ling99LL/ag32-logic-analyzer/docs/README.md

# 文档索引

| 路径 | 内容 |
|---|---|
| `docs/HANDOVER.md` | 环境、烧录流程、CPLD 三段式编译和排障 |
| `docs/reports/PERFORMANCE_REPORT.md` | 采样、触发、USB 吞吐和连续压测 |
| `docs/reports/TEST_REPORT_2026-10-21_PIN5_CH1.md` | PIN_5 到 CH1 的最近一次板级回环报告 |
| `docs/images/plan_b_live_waveform.svg` | 方案 B 实时波形示意 |

新增长期维护的分析和测试结论放 `reports/`；照片与截图优先放对应工程目录，跨工程示意图才放 `images/`。
