ling99LL/ag32-logic-analyzer/mcp/docs/images/ag32-logic-studio-mobile.png

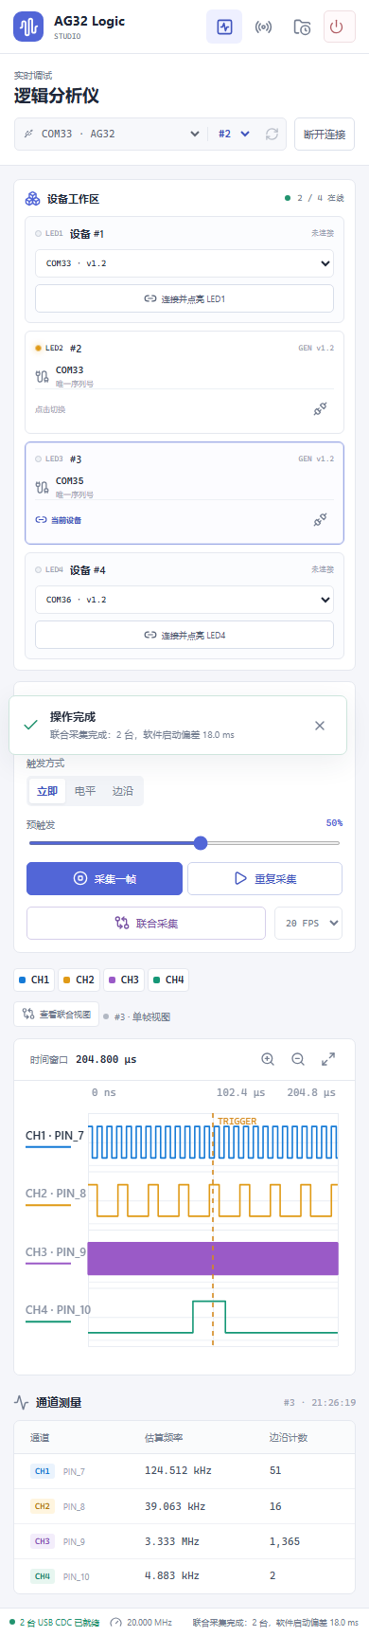
mcp/docs/images/ag32-logic-studio-mobile.png
