ling99LL/ag32-logic-analyzer/hardware/enclosure/top-case.step

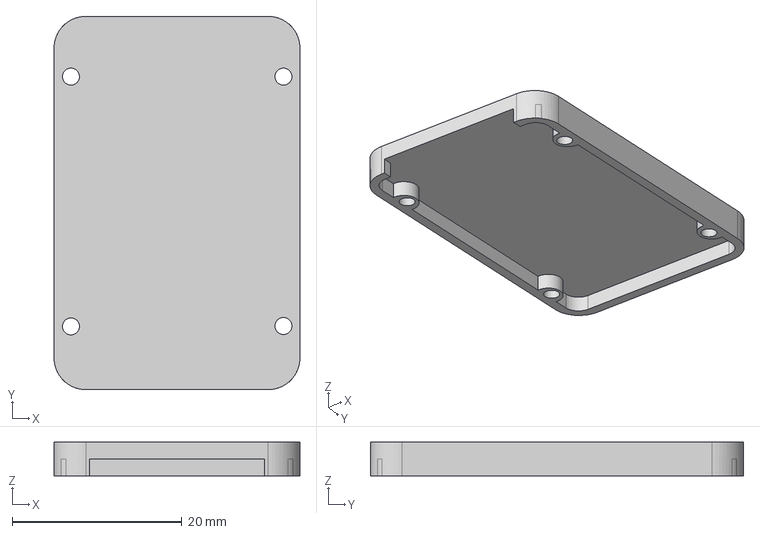
[picture p14: CAD file, 2026-10-21]
hardware/enclosure/top-case.step
29.0 x 44.0 x 4.00 mm
