ling99LL/ag32-logic-analyzer/hardware/enclosure/bottom-case.step

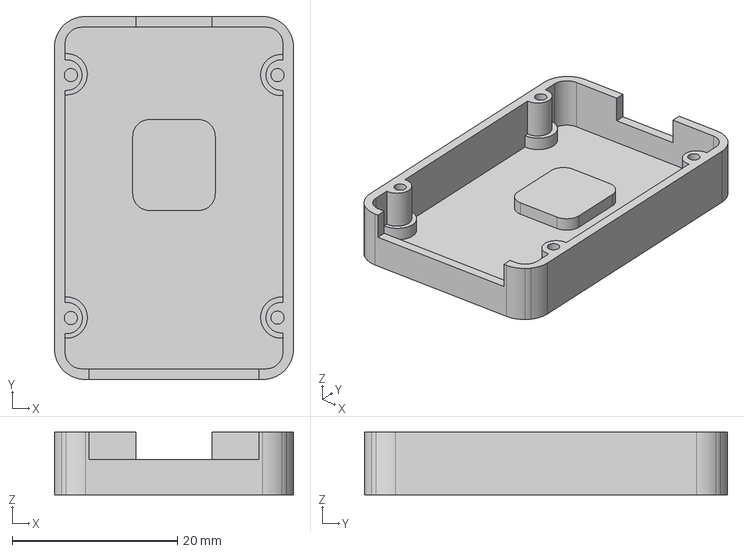
[picture p15: CAD file, 2026-10-21]
hardware/enclosure/bottom-case.step
29.0 x 44.0 x 7.60 mm
