ling99LL/ag32-logic-analyzer/hardware/images/assembled-board-hero.jpg

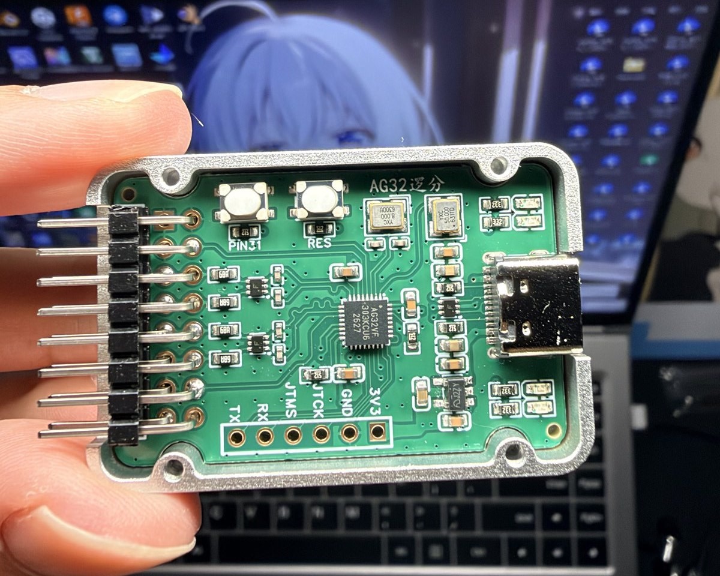
hardware/images/assembled-board-hero.jpg
