ling99LL/ag32-logic-analyzer/hardware/images/assembled-board-portrait.jpg

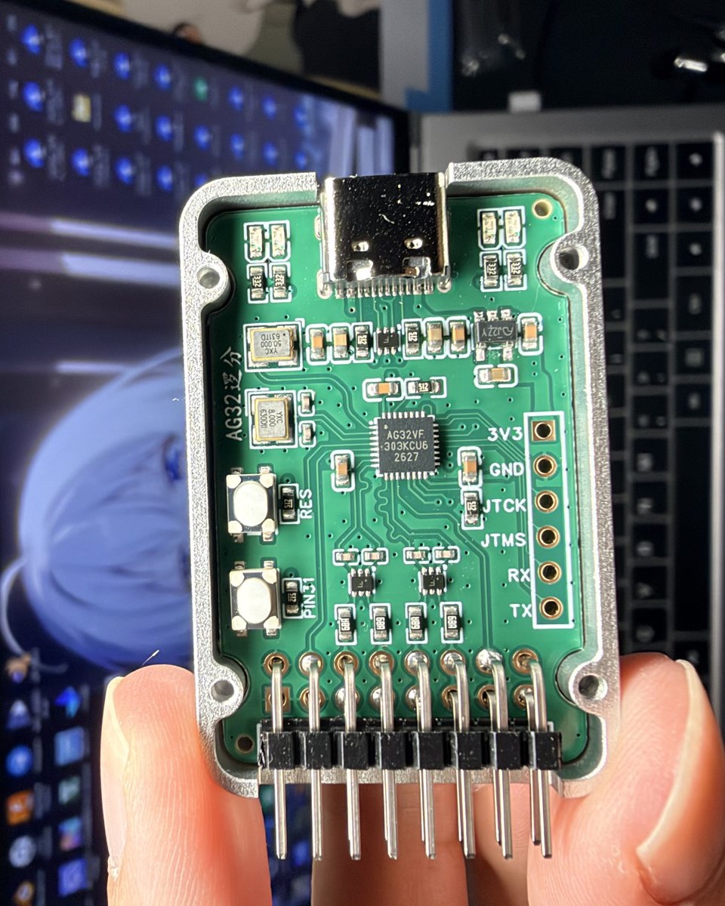
hardware/images/assembled-board-portrait.jpg
