ling99LL/ag32-logic-analyzer/hardware/images/assembled-board.jpg

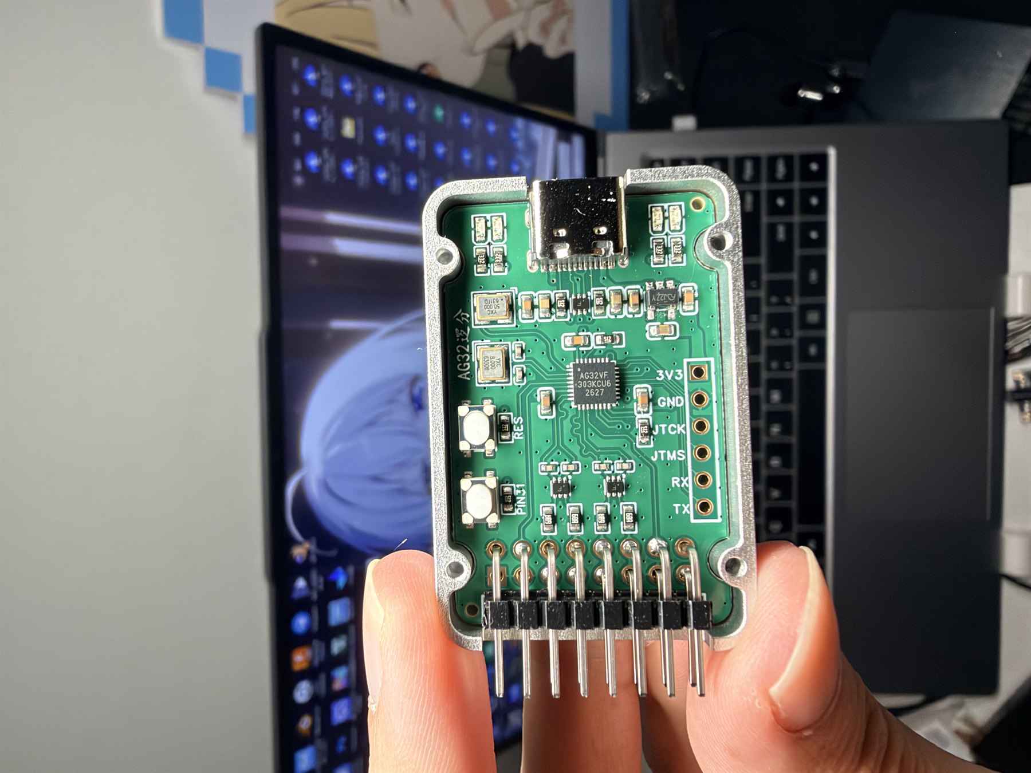
hardware/images/assembled-board.jpg
