ling99LL/ag32-logic-analyzer/TEST_REPORT_2026-10-21_PIN5_CH1.md

# Logic PIN_5 -> CH1 回环与性能测试报告

- 测试日期：2026-10-21
- 测试对象：AG32VF303 QFN32 逻辑分析仪
- 固件版本：`v1.1`
- 设备接口：`COM33`，SUMP ID `1ALS`
- 当前接线：`PIN_5` 数字输出 -> `CH1/PIN_7`
- 芯片采样基准：`100 MHz/(div+1)`，最高 `100 MSa/s`
- DAC 输出速率上限：`5 MSa/s`

## 1. 接线确认

本轮只连接了 `PIN_5 -> CH1/PIN_7`。

| 时间点 | CH1/PIN_7 | CH2/PIN_8 | CH3/PIN_9 | CH4/PIN_10 |
|---|---:|---:|---:|---:|
| PIN_5 关闭 | 0 边沿 | 0 边沿 | 0 边沿 | 0 边沿 |
| PIN_5 输出 100 kHz | 16 边沿 | 0 边沿 | 0 边沿 | 0 边沿 |
| DAC 使能但未接输入 | 仍为 PIN_5 信号 | 0 边沿 | 0 边沿 | 0 边沿 |

结论：

- `PIN_5` 确实只回读到 `CH1/PIN_7`。
- `CH2~CH4` 均保持静态，未观察到他路信号或浮空串扰。
- `PIN_11` 本轮未接任何输入，DAC 只能完成协议级测试，不能做物理波形捕获。

## 2. 冒烟测试

运行命令：

```powershell
cd <repository>
python .\tools\smoke_test.py COM33
```

结果：`23 PASS / 1 FAIL / 24 total`

通过项包括：

- SUMP/OLS 握手：`1ALS`
- GEN `v1.1`、DAC 关闭、PIN_5 方波源启动状态
- CPLD 8192 点满深捕获
- PIN_5 100 kHz、1 MHz、10 MHz 方波回环
- 触发/脉冲引擎寄存器级时序
- DAC 四波形协议与关闭状态
- 默认状态恢复

唯一失败项：

```text
脉冲波形: 延时~0.2s 上升 + 0.3s 高电平
上升沿@320ms，高电平宽=300ms
```

该失败不是脉冲宽度错误。旧脚本先发送 `fire`，再逐条配置采样参数，因此把主机配置耗时算进了期望的 200 ms 延时。实际高电平宽度为准确的 300 ms。

改用硬件上升沿触发复核后：

```text
bytes: 8192
high: 3000
low: 5192
edges: [5186, 8186]
pulse_width_ms: [300.0]
CH2/CH3/CH4 edges: [0, 0, 0]
```

结论：脉冲引擎和采样通道工作正常，冒烟脚本的波形起点判断需要后续修正。

## 3. 高频回环

### 3.1 标准回归

运行命令：

```powershell
python .\live_hardware_test.py
```

8 档时基全部通过，但脚本内置的高频子测试只在切换 `TEST_DIV` 后等待 10 ms。该等待时间不足以让 50 MHz 方波稳定进入当前采样相位，因此出现过一次：

```text
50 MHz @ 100 MSa/s: edges=0, expected=1024, FAIL
```

25 MHz、10 MHz 及更低频点均通过。

### 3.2 增加稳定时间后的复测

将 `PIN_5` 频率切换后等待 50 ms，再启动 100 MSa/s、8192 点捕获：

| PIN_5 频率 | 采样点/周期 | 捕获次数 | 边沿范围 | 占空比 | 结果 |
|---:|---:|---:|---:|---:|---|
| 50 MHz | 2 | 100 | 8191/8191 | 50.0% | 100/100 PASS |
| 33.333 MHz | 3 | 20 | 5460~5461 | 66.7% | 20/20 PASS |
| 25 MHz | 4 | 20 | 4095~4096 | 50.0% | 20/20 PASS |

结论：

- 等待 10 ms 时，50 MHz 存在偶发相位锁定失败。
- 等待 50 ms 后，50 MHz 连续 100 帧均为严格 `1010...` 交替模式，可稳定回环。
- `50 MHz` 是 `100 MSa/s` 下的奈奎斯特极限，只有 2 点/周期。
- `PIN_5` 虽然可配置到 100 MHz，但 100 MHz 在 100 MSa/s 下只有 1 点/周期，无法可靠恢复波形。
- 协议解码建议信号不超过 25 MHz，以保证每 bit 至少 4 个采样点。

## 4. 采样时基

`live_hardware_test.py` 的 8 档绝对时基检查全部通过：

| 采样率 | 分频 | 测试源频率 | 捕获结果 |
|---:|---:|---:|---|
| 100 MSa/s | 0 | 50 MHz | 512 High / 512 Low，1023 边沿 |
| 50 MSa/s | 1 | 25 MHz | 512 High / 512 Low，1023 边沿 |
| 20 MSa/s | 4 | 10 MHz | 512 High / 512 Low，1023 边沿 |
| 10 MSa/s | 9 | 20 kHz | 500 High / 524 Low，4 边沿 |
| 5 MSa/s | 19 | 20 kHz | 518 High / 506 Low，9 边沿 |
| 2 MSa/s | 49 | 20 kHz | 508 High / 516 Low，21 边沿 |
| 1 MSa/s | 99 | 20 kHz | 514 High / 510 Low，41 边沿 |
| 100 kSa/s | 999 | 20 kHz | 614 High / 410 Low，410 边沿 |

关键指标：

- 最高采样率：`100 MSa/s`
- 时间分辨率：`10 ns`
- BRAM 满深：`8192` 点
- 100 MSa/s 满深时间窗口：`81.92 us`

## 5. USB 与连续性能

### 5.1 纯 USB CDC 连续吞吐

运行命令：

```powershell
python .\benchmark_usb_suite.py
```

| 负载 | 接收字节 | 耗时 | 有效吞吐 | 线速率 |
|---:|---:|---:|---:|---:|
| 16 KB | 16384 | 15.57 ms | 1027.49 KB/s | 8.42 Mbps |
| 32 KB | 32768 | 30.32 ms | 1055.33 KB/s | 8.65 Mbps |
| 64 KB | 65536 | 60.46 ms | 1058.53 KB/s | 8.67 Mbps |
| 128 KB | 131072 | 121.75 ms | 1051.33 KB/s | 8.61 Mbps |
| 256 KB 首轮 | 262144 | 325.47 ms | 786.55 KB/s | 6.44 Mbps |

256 KB 首轮出现了 Windows CDC 调度抖动。连续复测 3 次：

```text
1011.75 KB/s
1012.08 KB/s
1002.70 KB/s
```

因此 256 KB 连续流稳定值约为 `1.00~1.01 MB/s`，单次 786 KB/s 不是持续吞吐上限。

### 5.2 满深捕获上传

`live_hardware_test.py` 的 8192 点上传：

```text
Upload Length: 8192 / 8192 bytes
Effective Net USB: 1003.6 KB/s
Pure upload time: 7.97 ms
```

### 5.3 满深连续压测

测试配置：100 MSa/s、8192 点、连续 200 帧。

结果：

- 完整帧：`200/200`
- 丢帧：`0`
- 端到端帧率：`21.92 FPS`
- 平均单帧：`45.58 ms`
- 最短单帧：`42.82 ms`
- 最长单帧：`123.54 ms`
- 端到端有效吞吐：`175.4 KB/s`

当前固件每次上传后固定保留 35 ms LED 展宽，因此连续满深帧率主要受该延时限制，而不是 USB 或 CPLD 采样限制。

## 6. 最终结论

1. `PIN_5 -> CH1/PIN_7` 单线回环工作正常，其他通道无串扰。
2. 逻辑分析仪最高采样率为 `100 MSa/s`，对应 `10 ns` 分辨率。
3. 当前已验证的最高数字回环频率为 `50 MHz`，但必须满足 2 点/周期的奈奎斯特条件。
4. 50 MHz 测试必须在修改 `TEST_DIV` 后等待约 50 ms；现有脚本的 10 ms 等待会产生偶发假失败。
5. 25 MHz 及以下具有至少 4 点/周期，可靠性更高，适合协议解码。
6. 纯 USB CDC 峰值实测 `1058.53 KB/s`，256 KB 连续流稳定约 `1.00~1.01 MB/s`。
7. 满深连续捕获 `200/200` 帧通过，端到端约 `21.92 FPS`。

测试结束后设备恢复为：

- 固件 `v1.1`
- `FLAGS=0x02`
- DAC 关闭
- `PIN_5` 方波源，100 kHz
- SUMP ID `1ALS`
