ling99LL/ag32-logic-analyzer/(commit log)

2026-10-08 feat(logic): 新增 AG32VF303 4通道逻辑分析仪工程 (QFN-32版，支持SUMP与PulseView原生对接)
    - 硬件平台：AG32VF303 (AGRV2KQ32) QFN-32 封装适配
    - 采样通道：PIN_7~10 (CH0~CH3) + PIN_11 (TEST_OUT 自检方波输出)
    - 状态指示：PIN_12/13/14/18 (4颗LED) 支持上电自检、待机跑马灯与状态指示
    - 协议引擎：兼容 SUMP/OLS 标准协议，原生支持 PulseView / Sigrok
    - 性能实测：64KB 单次采集深度，USB CDC 传输带宽约 827 KB/s
    - 包含工程源码、VE约束、测试脚本及完整技术说明文档
2026-10-08 feat(logic): upgrade to Plan B CPLD hardware sampler (100MSa/s, BRAM buffer, HW trigger)
2026-10-08 feat(logic): support extended multi-stage SUMP trigger stages (0xC0..0xCF)
2026-10-08 feat(cpld): implement true hardware edge-trigger engine and wire to SUMP protocol
2026-10-08 feat(logic): add multi-sample-rate signal verification script
2026-10-08 feat(logic): support SUMP pre-trigger sample delay parsing
2026-10-08 feat(logic): adaptively scale CPLD test wave frequency to sample timebase
2026-10-08 feat(comm): non-blocking dual-port dispatch preventing UART from throttling USB CDC
2026-10-08 fix(logic): wire CPLD hardware edge trigger bit and align SUMP trigger mask/val parsing
2026-10-08 feat(cpld): add 2-stage input synchronizer pipeline for instant edge triggering and update 800fps bench
2026-10-08 feat(led): enhance LED visual feedback with extended stretch and rotating heartbeat
2026-10-10 fix(logic): hardware-verified SUMP sampler corrections
    - timebase: sample rate = 100MHz/(div+1) on a real 100MHz bus domain (VE adds BUSCLK 100); 16-bit divider fixes truncation above divider 255 (100kSa/s was really 431kSa/s)
    - implement true circular pre-trigger buffer in CPLD (pre-fill + trig_pos latch + post_cnt) and read the window around REG_TRIG_POS in firmware
    - latch trigger every bus cycle (trig_pending) so edge trigger works on phase-locked signals (self-test wave never triggered before, only force-timeout)
    - fix REG_CTRL readback layout (was 33-bit concat shifted one bit); verified via OpenOCD mem2array
    - fix run_la.py swapped SUMP 0xC0(mask)/0xC1(value); fix all scripts to s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
2026-10-10 feat(logic): raise self-test square wave to 10/25/50 MHz + on-board loopback verification
2026-10-12 fix(logic): resurrect DAC hard macro + calibrate DMA pacing; add board test tools
    - analog_ip.v: keep-guard (preserve register) on the dangling dac_dout - Quartus
    had deleted the whole alta_dac macro as dead logic, which silently killed the
    PIN_11 analog output and the Supra FIXED_COORD {22 11} binding
    - run_quartus_steps.bat: new [1/7] af_ip.tcl step generating the alta_auto macro
    partitions, plus two hard guards (missing partition in qsf / missing alta_dac
    in the netlist abort the build) so this regression cannot ship again
    - main.c: repeat the wave table across the whole DMA buffer and set the LLI
    transferSize to the full buffer (reloads every few samples stole DMA request
    s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
2026-10-12 docs(logic): record DAC macro fix, pacing calibration and loopback 18/18 in handover/README/AGENTS
    - HANDOVER: new "当前版本" (62f7375, board now matches the repo), loopback 18/18
    results, smoke 19/19 final, the alta_dac keep-guard / partition-guard
    post-mortem, 5 MSa/s pacing calibration, remaining PIN_5 + LED TODO
    - README: flag the two build-script guards as load-bearing, document the DAC
    pacing requirements in §9.5 (16-cycle AHB->APB handshake, whole-buffer repeat,
    5 MSa/s cap), refresh the rate-cap defaults and accuracy wording (divider
    grid residual ~+-0.5%); wavegen GUI default rate cap 25 -> 5 MSa/s
    - AGENTS: keep-guard and build guards are mandatory, loopback-verifi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
2026-10-12 docs(logic): sync README/handover/workspace docs with the DAC fix and generator rollout
    - Logic/README: 2026-10-12 revision block - signal generator (PIN_11 DAC +
    PIN_5 digital/trigger engine + GUI), alta_dac keep-guard + build guards,
    5 MSa/s pacing calibration, loopback 18/18 & smoke 19/19, Supra P&R
    nondeterminism caveat; analyzer sample rate explicitly unchanged (100 MSa/s)
    - docs/HANDOVER (workspace): correct the wrong "af_ip.tcl assignments are only
    optimization hints, not functionally required" note in §9.3 - dropping the
    alta_auto partitions deletes hard macros on such designs; add fast-fail
    293007 and dead-hard-macro entries to the §5 troubleshooting table; header not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
2026-10-14 chore: 归档工作区散件——器件手册/原理图PDF/测试脚本/抓图
    - docs/FOC驱动板原理图.pdf：三相输入跟随驱动板原理图（foc_knob 配套）
    - 手册：drv8316/esd/usblc6-2p6/led/osc 数据手册 + esd_text.txt + lcsc 页面存档
    - 抓图：osc_page_1-4、led_page_4、pulseview_check、capture.vcd
    - 调试脚本：test_supra.tcl（Supra 探针）、test_{gpio,pc,read,state}.cfg（OpenOCD 寄存器读回）
    - Logic/benchmark_usb.py：USB CDC 吞吐基准测试
2026-10-17 chore(workspace): 散件按工程归档 + 建立三层索引
    根目录 22 个散件按归属归档（旧→新映射见 INDEX.md 第 3 节）：
    - FOC2205/docs/hardware/：自研板原理图、EasyEDA 网表、器件规格书
    （MT6701QT-STD / DRV8316CRRGFR / TI-DRV8316 / 50MHz 晶振 YSO110TR /
    USBLC6-2P6 ESD / GL0603UG01 LED）与 LCSC 商城页存档、easyeda-review 导出
    - Logic/captures/：planb-capture-2026-10-10.vcd、PulseView 连接验证截图
    - tools/openocd|supra/：OpenOCD 直读探针（PC/Flash/GPIO4/UART）+ Supra 器件自检
    - ref-smartknob/upstream-assets/：上游 KiCad 原理图、文件树、源码包
    索引：新增根目录 INDEX.md（工程总览/目录树/归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
2026-10-21 docs: tighten product overview
2026-10-21 docs: add hardware photos schematic and enclosure models
2026-10-24 docs: add assembled hardware photos
2026-11-01 docs: refresh project landing page for v0.1.2
2026-11-02 feat(led): assign one-hot device identity from host
2026-11-02 feat: add multi-device workspace and synchronized capture
2026-11-02 fix: isolate multi-device waveforms and output drafts
